martin2250/SinglePhaseEnergyMonitor/README.md

# SinglePhaseEnergyMonitor

an adapter to plug between a device and an outlet, to monitor electricity usage and provide data to influxdb
