martin2250/SinglePhaseEnergyMonitor/Hardware/SinglePhaseEnergyMonitor.kicad_pcb

## KiCad design Hardware/SinglePhaseEnergyMonitor.kicad_pcb (2019-02-06)

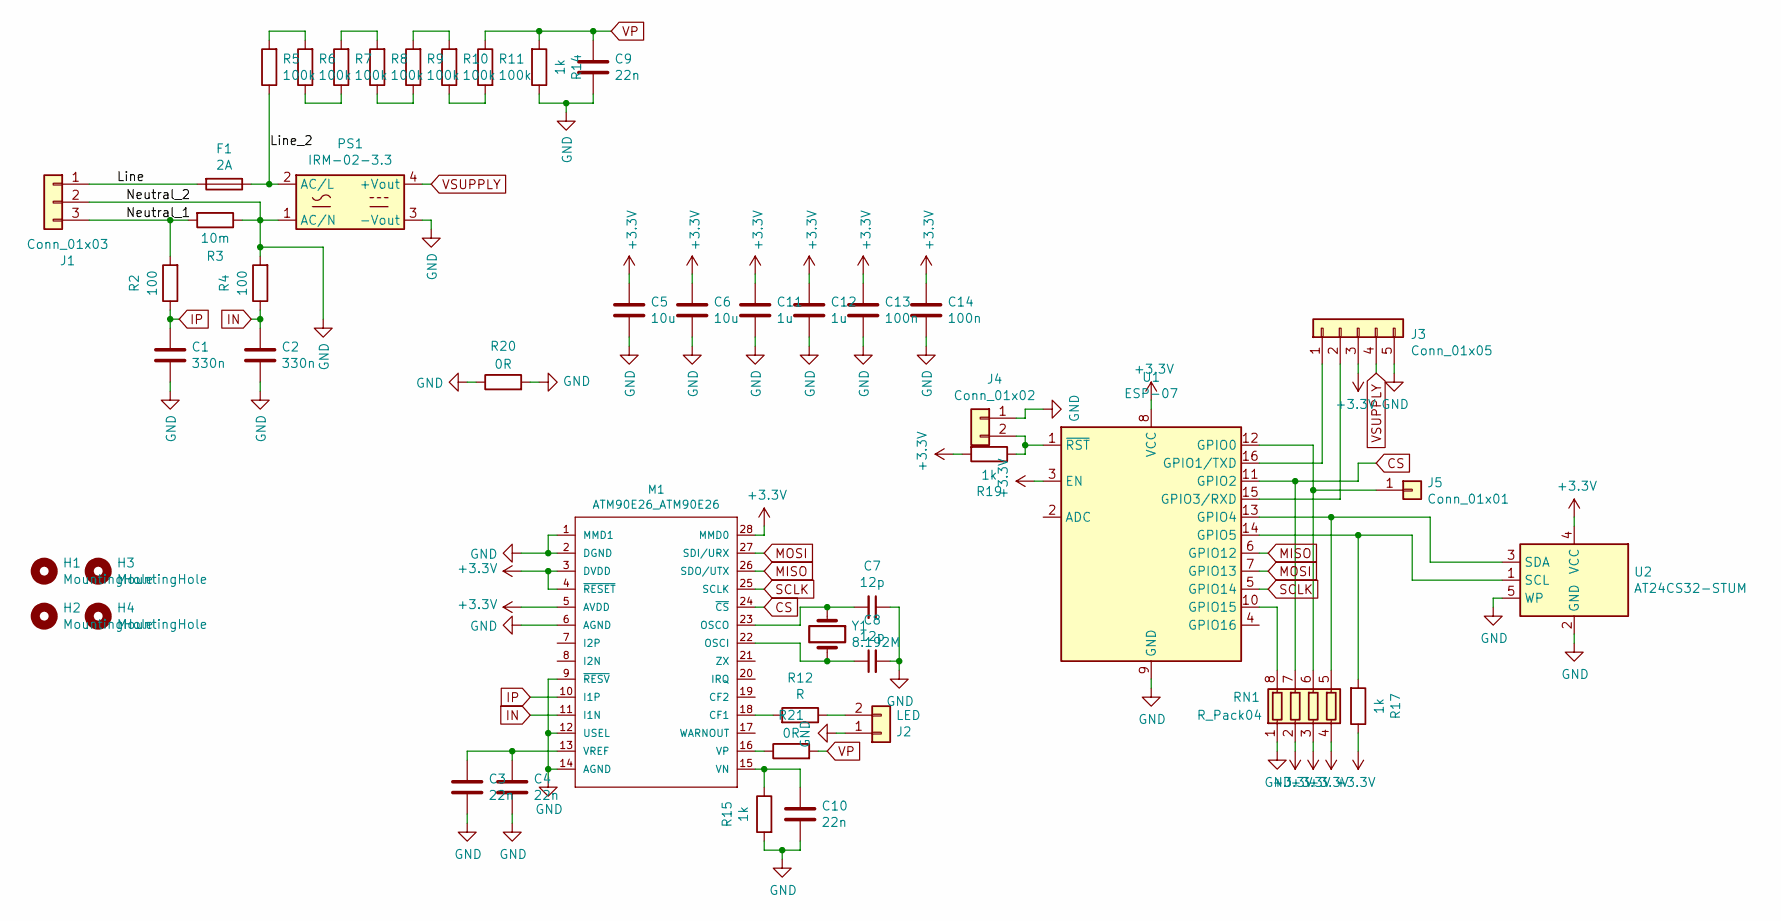
[picture p1: schematic SinglePhaseEnergyMonitor.sch]

Parts:
C1, C2: 330n; C_1206_3216Metric
C3, C4, C9, C10: 22n; C_0805_2012Metric
C5, C6: 10u; C_1206_3216Metric
C7, C8: 12p; C_0805_2012Metric
C11, C12: 1u; C_0805_2012Metric
C13, C14: 100n; C_0805_2012Metric
F1: 2A; Fuseholder_Cylinder-5x20mm_Stelvio-Kontek_PTF78_Horizontal_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
H1, H2, H3, H4: MountingHole; MountingHole_3mm
J1: Conn_01x03; TerminalBlock_RND_205-00046_1x03_P5.00mm_Horizontal
J2: LED; PinHeader_1x02_P2.54mm_Vertical
J3: Conn_01x05; PinHeader_1x05_P2.54mm_Vertical
J4: Conn_01x02; PinHeader_1x02_P2.54mm_Vertical
J5: Conn_01x01; Pin_D0.9mm_L10.0mm_W2.4mm_FlatFork
M1: ATM90E26_ATM90E26; SSOP-28_5.3x10.2mm_P0.65mm
PS1: IRM-02-3.3; Converter_ACDC_MeanWell_IRM-02-xx_THT
R2, R4: 100; R_1206_3216Metric
R3: 10m; R_Box_L14.0mm_W5.0mm_P9.00mm
R5, R6, R7, R8, R9, R10, R11: 100k; R_1206_3216Metric
R12: R; R_1206_3216Metric
R14, R15, R17, R19: 1k; R_0805_2012Metric
R20, R21: 0R; R_1206_3216Metric
RN1: R_Pack04; R_Array_Convex_4x0603
U1: ESP-07
U2: AT24CS32-STUM; SOT-23-5
Y1: 8.192M; Crystal_SMD_HC49-SD

Connections:
+3V3: C5.2, C6.2, C11.2, C12.2, C13.2, C14.2, J3.3, M1.3 (DVDD), M1.4 (~RESET), M1.5 (AVDD), M1.28 (MMD0), R17.1, R19.2, RN1.2 (R2.1), RN1.3 (R3.1), RN1.4 (R4.1), U1.3 (EN), U1.8 (VCC), U2.4 (VCC)
/Line: F1.2, J1.1
/Line_2: F1.1, PS1.2 (AC/L), R5.1
/Neutral_1: J1.3, R2.2, R3.2
CS: M1.24 (~CS), RN1.7 (R2.2), U1.11 (GPIO2)
GND: C1.2, C2.1, C3.1, C4.1, C5.1, C6.1, C7.1, C8.2, C9.1, C10.1, C11.1, C12.1, C13.1, C14.1, J1.2, J2.1, J3.5, J4.1, M1.1 (MMD1), M1.2 (DGND), M1.6 (AGND), M1.9 (~RESV), M1.12 (USEL), M1.14 (AGND), PS1.1 (AC/N), PS1.3 (-Vout), R3.1, R4.2, R14.1, R15.2, R20.1, R20.2, RN1.1 (R1.1), U1.9 (GND), U2.2 (GND), U2.5 (WP)
IN: C2.2, M1.11 (I1N), R4.1
IP: C1.1, M1.10 (I1P), R2.1
MISO: M1.26 (SDO/UTX), U1.6 (GPIO12)
MOSI: M1.27 (SDI/URX), U1.7 (GPIO13)
unnamed: C3.2, C4.2, M1.13 (VREF)
unnamed: C7.2, M1.23 (OSCO), Y1.1
unnamed: C8.1, M1.22 (OSCI), Y1.2
unnamed: C10.2, M1.15 (VN), R15.1
unnamed: J2.2, R12.1
unnamed: J3.1, U1.16 (GPIO1/TXD)
unnamed: J3.2, U1.15 (GPIO3/RXD)
unnamed: J4.2, R19.1, U1.1 (~RST)
unnamed: J5.1, RN1.6 (R3.2), U1.12 (GPIO0)
unnamed: M1.16 (VP), R21.1
unnamed: M1.18 (CF1), R12.2
unnamed: R5.2, R6.2
unnamed: R6.1, R7.1
unnamed: R7.2, R8.2
unnamed: R8.1, R9.1
unnamed: R10.1, R11.2
unnamed: R9.2, R10.2
unnamed: R17.2, U1.14 (GPIO5), U2.1 (SCL)
unnamed: RN1.5 (R4.2), U1.13 (GPIO4), U2.3 (SDA)
unnamed: RN1.8 (R1.2), U1.10 (GPIO15)
SCLK: M1.25 (SCLK), U1.5 (GPIO14)
VP: C9.2, R11.1, R14.2, R21.2
VSUPPLY: J3.4, PS1.4 (+Vout)

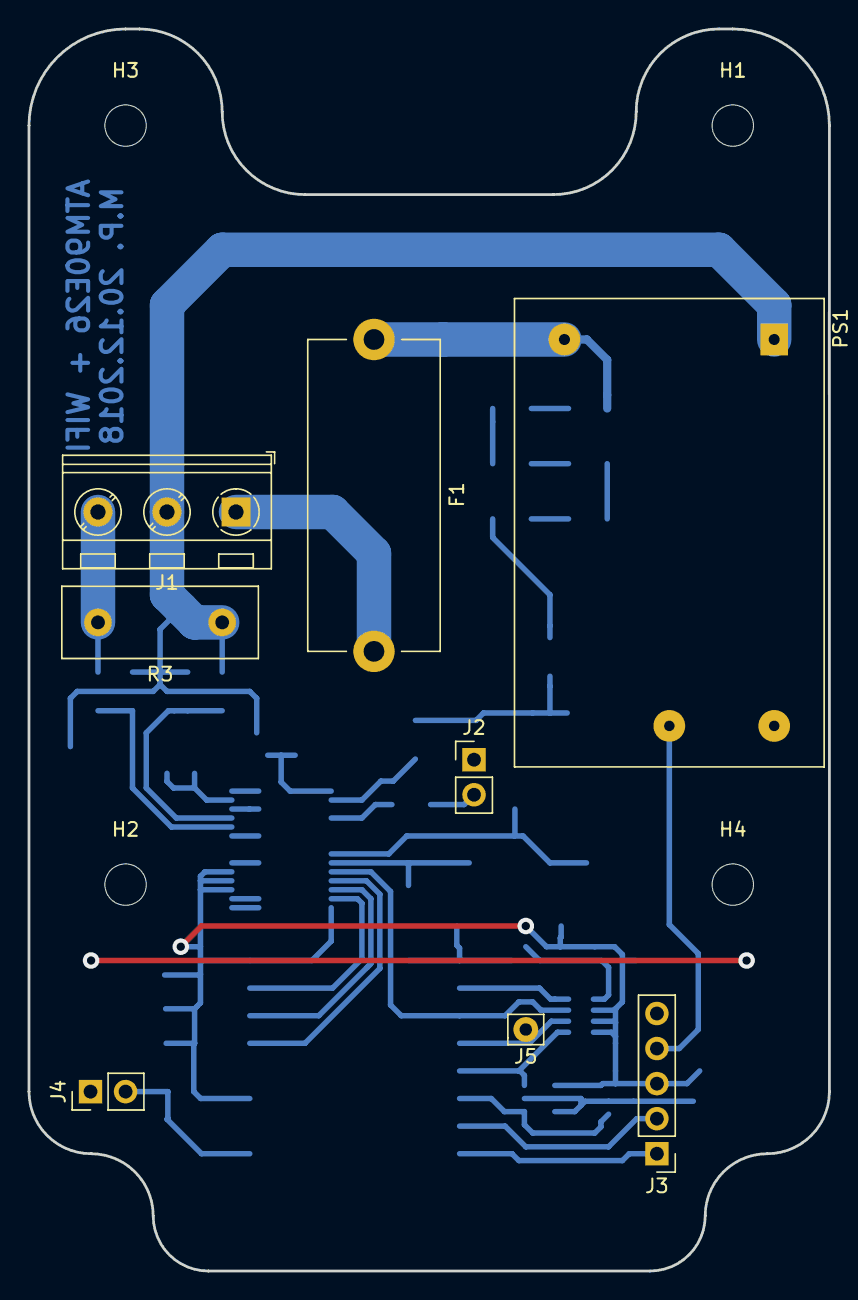
[picture p2: board SinglePhaseEnergyMonitor.kicad_pcb from above]

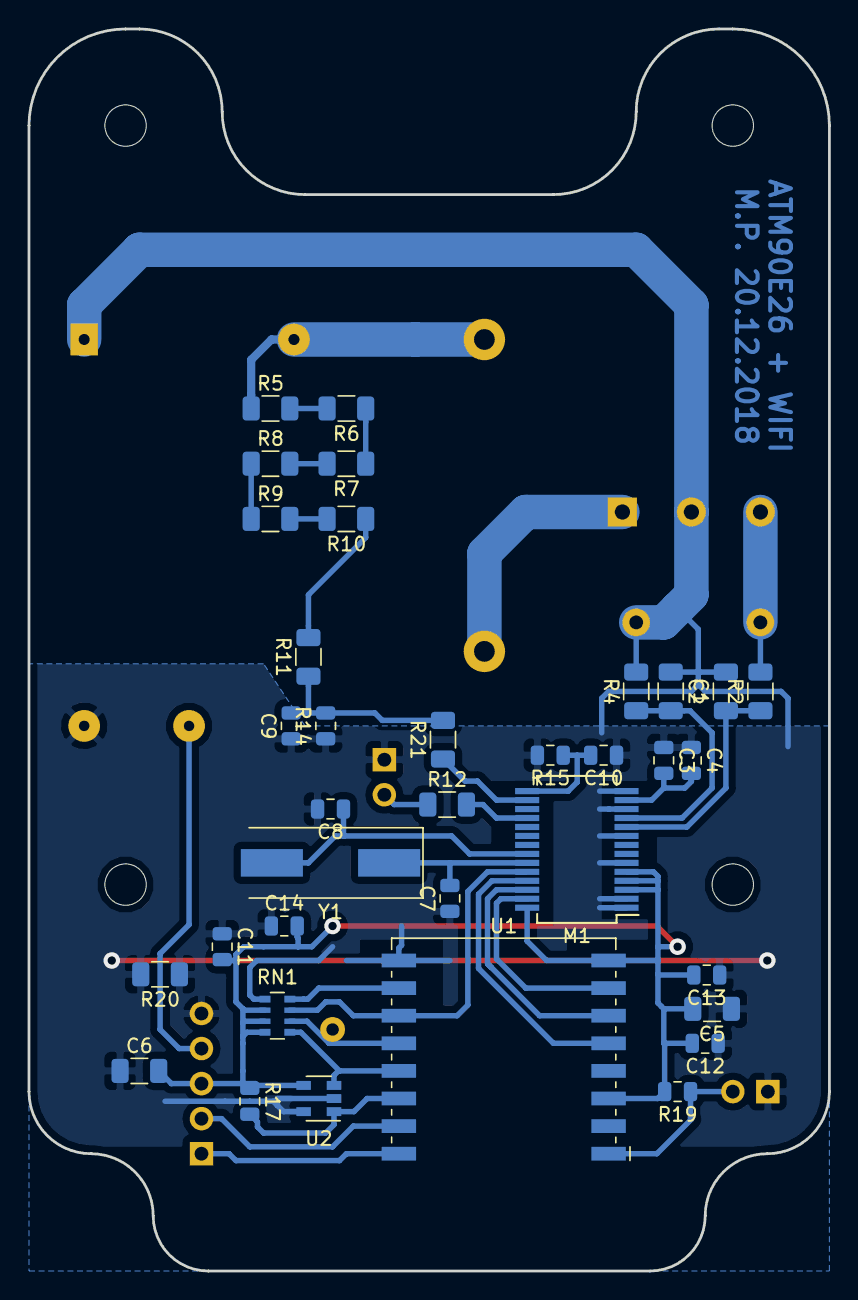
[picture p3: board SinglePhaseEnergyMonitor.kicad_pcb from below]

Board: 2 copper layers, 58.0 x 90.0 mm, 47 parts (35 on the bottom side), 33 nets.
