martin2250/SinglePhaseEnergyMonitor/(commit log)

2018-12-25 improve layout
    [SinglePhaseEnergyMonitor.kicad_pcb, SinglePhaseEnergyMonitor.sch]
2019-02-06 fix pcb
    [SinglePhaseEnergyMonitor.kicad_pcb, SinglePhaseEnergyMonitor.sch]
2019-02-19 major rework to use settingsmanager library
    [ATM90E26.cpp, eeprom.cpp, globals.cpp, globals.h, main.cpp, metrics.cpp, metrics.h]
